r2p-old/IMU_module/hw/IMU_module.brd

## EAGLE design hw/IMU_module.brd (2015-03-15)

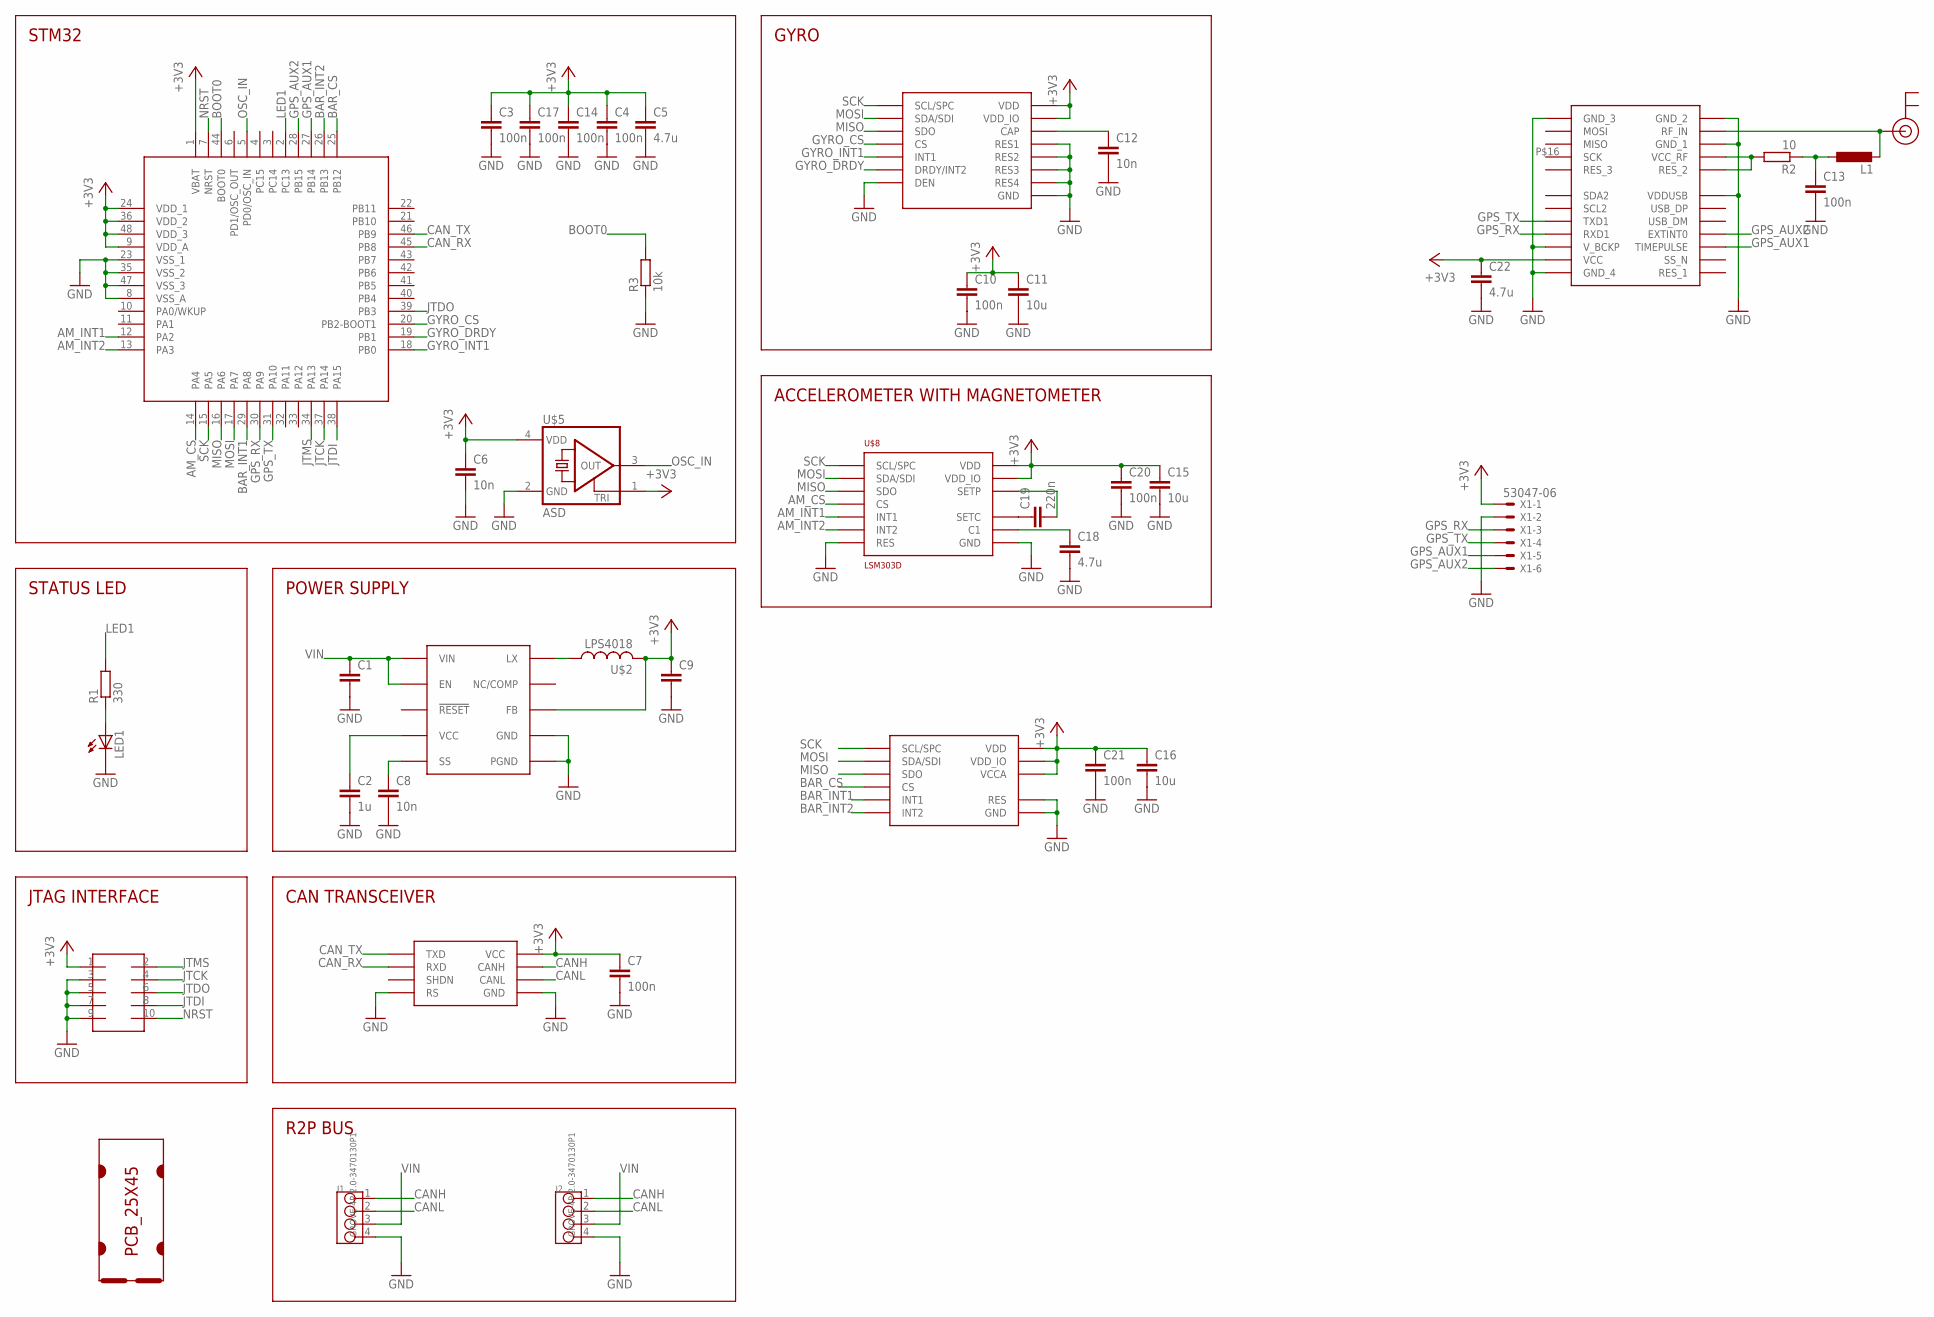
[picture p1: schematic IMU_module.sch]

Parts:
C1: C-EUC1206; C1206
C2: 1u; C0603
C3, C4, C7, C10, C13, C14, C17, C20, C21: 100n; C0603
C5, C18, C22: 4.7u; C0805
C6, C8, C12: 10n; C0603
C9: C-EUC0805; C0805
C11, C15, C16: 10u; C0805
C19: 220n; C0603
J1, J2: GROVE-4P-2.0-3470130P1; 4P-2.0
L1: L-EUL2012C; L2012C
LED1: LEDCHIPLED_0805; CHIPLED_0805
R1: 330; R0603
R2: 10; R0603
R3: 10k; R0603
SOT1: MAX3051EKA; SOT23-8L
U$1: PCB_25X45; 25X45
U$2: LPS4018
U$3: MAX17501; TDFN-10
U$4: FTSH-105TH; FTSH-105-TH
U$5: ASD; 2.5X2
U$6: STM32F103CXTX; LQFP48
U$7: L3GD20H; LGA16L
U$8: LSM303D; LGA16L
U$9: LPS331AP; LGA16L
U$10: NEO-6; NEO
U$11: U.FL
X1: 53047-06

Connections:
+3V3: C3.1, C4.1, C5.1, C6.1, C7.1, C9.1, C10.1, C11.1, C14.1, C15.1, C16.1, C17.1, C20.1, C21.1, C22.1, SOT1.3 (VCC), U$2.P$2 (2), U$3.P$5 (FB), U$4.1, U$5.1 (TRI), U$5.4 (VDD), U$6.1 (VBAT), U$6.9 (VDD_A), U$6.24 (VDD_1), U$6.36 (VDD_2), U$6.48 (VDD_3), U$7.P$1 (VDD_IO), U$7.P$16 (VDD), U$8.P$1 (VDD_IO), U$8.P$14 (VDD), U$9.P$1 (VDD_IO), U$9.P$14 (VDD), U$9.P$15 (VCCA), U$10.P$23 (VCC), X1.1
AM_CS: U$6.14 (PA4), U$8.P$8 (CS)
AM_INT1: U$6.12 (PA2), U$8.P$11 (INT1)
AM_INT2: U$6.13 (PA3), U$8.P$9 (INT2)
BAR_CS: U$6.25 (PB12), U$9.P$8 (CS)
BAR_INT1: U$6.29 (PA8), U$9.P$11 (INT1)
BAR_INT2: U$6.26 (PB13), U$9.P$9 (INT2)
BOOT0: R3.2, U$6.44 (BOOT0)
CANH: J1.1, J2.1, SOT1.7 (CANH)
CANL: J1.2, J2.2, SOT1.6 (CANL)
CAN_RX: SOT1.4 (RXD), U$6.45 (PB8)
CAN_TX: SOT1.1 (TXD), U$6.46 (PB9)
GND: C1.2, C2.2, C3.2, C4.2, C5.2, C6.2, C7.2, C8.2, C9.2, C10.2, C11.2, C12.2, C13.2, C14.2, C15.2, C16.2, C17.2, C18.2, C20.2, C21.2, C22.2, J1.4, J2.4, LED1.C, R3.1, SOT1.2 (GND), SOT1.8 (RS), U$3.P$1 (PGND), U$3.P$9 (GND), U$3.P$11 (PGND), U$4.3, U$4.5, U$4.7, U$4.9, U$5.2 (GND), U$6.8 (VSS_A), U$6.23 (VSS_1), U$6.35 (VSS_2), U$6.47 (VSS_3), U$7.P$8 (DEN), U$7.P$9 (RES1), U$7.P$10 (RES2), U$7.P$11 (RES3), U$7.P$12 (GND), U$7.P$13 (GND), U$7.P$15 (RES4), U$8.P$5 (GND), U$8.P$10 (RES), U$8.P$12 (GND), U$8.P$13 (GND), U$8.P$16 (GND), U$9.P$5 (GND), U$9.P$10 (RES), U$9.P$12 (GND), U$9.P$13 (GND), U$9.P$16 (GND), U$10.P$7 (VDDUSB), U$10.P$10 (GND_1), U$10.P$12 (GND_2), U$10.P$13 (GND_3), U$10.P$22 (V_BCKP), U$10.P$24 (GND_4), X1.2
GPS_AUX1: U$6.27 (PB14), U$10.P$3 (TIMEPULSE), X1.5
GPS_AUX2: U$6.28 (PB15), U$10.P$4 (EXTINT0), X1.6
GPS_RX: U$6.30 (PA9), U$10.P$21 (RXD1), X1.3
GPS_TX: U$6.31 (PA10), U$10.P$20 (TXD1), X1.4
GYRO_CS: U$6.20 (PB2-BOOT1), U$7.P$5 (CS)
GYRO_DRDY: U$6.19 (PB1), U$7.P$6 (DRDY/INT2)
GYRO_INT1: U$6.18 (PB0), U$7.P$7 (INT1)
JTCK: U$4.4, U$6.37 (PA14)
JTDI: U$4.8, U$6.38 (PA15)
JTDO: U$4.6, U$6.39 (PB3)
JTMS: U$4.2, U$6.34 (PA13)
LED1: R1.2, U$6.2 (PC13)
MISO: U$6.16 (PA6), U$7.P$4 (SDO), U$8.P$7 (SDO), U$9.P$7 (SDO)
MOSI: U$6.17 (PA7), U$7.P$3 (SDA/SDI), U$8.P$6 (SDA/SDI), U$9.P$6 (SDA/SDI)
unnamed: U$2.P$1 (1), U$3.P$10 (LX)
unnamed: C12.1, U$7.P$14 (CAP)
unnamed: LED1.A, R1.1
unnamed: C18.1, U$8.P$15 (C1)
unnamed: C19.1, U$8.P$2 (SETC)
unnamed: C2.1, U$3.P$4 (VCC)
unnamed: C8.1, U$3.P$6 (SS)
unnamed: C19.2, U$8.P$3 (SETP)
unnamed: L1.2, U$10.P$11 (RF_IN), U$11.P$3 (SIGNAL)
unnamed: C13.1, L1.1, R2.1
unnamed: R2.2, U$10.P$8 (RES_2), U$10.P$9 (VCC_RF)
NRST: U$4.10, U$6.7 (NRST)
OSC_IN: U$5.3 (OUT), U$6.5 (PD0/OSC_IN)
SCK: U$6.15 (PA5), U$7.P$2 (SCL/SPC), U$8.P$4 (SCL/SPC), U$9.P$4 (SCL/SPC)
VIN: C1.1, J1.3, J2.3, U$3.P$2 (VIN), U$3.P$3 (EN)

Notes on the sheet:
STM32
STATUS LED
JTAG INTERFACE
POWER SUPPLY
CAN TRANSCEIVER
R2P BUS
ACCELEROMETER WITH MAGNETOMETER
GYRO

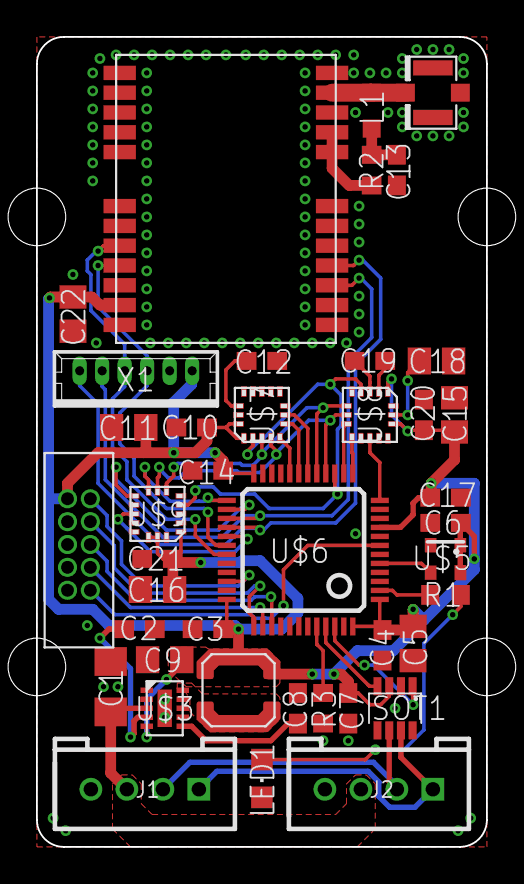
[picture p2: board IMU_module.brd from above]

Board: 2 copper layers, 25.0 x 45.0 mm, 42 parts (0 on the bottom side), 42 nets.
