r2p-old/IMU_module/(commit log)

2014-05-29 added MEMS datasheets to doc foder
    [IMU_module.brd, IMU_module.sch]
2014-05-29 added TIMEPULSE and INT0 signals
    [IMU_module.brd, IMU_module.sch]
2014-06-04 updated GPS connector to have Vcc on pin 1
    [IMU_module.brd, IMU_module.sch]
2014-06-23 Added makefile for quicker gerber generation
    [IMU_module.brd, IMU_module.sch]
2014-06-24 added PNG of board layout
2014-08-25 up to date
    [IMU_module.brd]
2014-12-16 small fixes for production
    [IMU_module.brd, IMU_module.sch]
2014-12-16 moved LSM303D interrupt lines
    [IMU_module.brd, IMU_module.sch]
2014-12-29 approved DRC false errors
    [IMU_module.brd, IMU_module.sch]
2015-01-08 added logo to bottom silkscreen
    [IMU_module.brd, IMU_module.sch]
2015-01-13 minor fixes for manufacturing
    [IMU_module.brd, IMU_module.sch]
2015-01-22 added assembly PDF generation
    [IMU_module.brd, IMU_module.sch]
2015-03-15 Renamed gyro DRDY signal and updated makefile
    [IMU_module.brd, IMU_module.sch]
